akumaraguru/EE40_Remote_Control/README.md

EE40_Remote_Control
===================

Final Project for EE40 Fall 2014
