akumaraguru/EE40_Remote_Control/FinalHackwithSchematics.pdf

# Final Hack: Remote Control

## 1 AUTHORS

Aravind Kumaraguru, Scout Heid

## 2 DESCRIPTION

This hack enables a fully wireless remote control of the robot using cheap Nordic radios operating at 2.4 GHz. The robot will be controlled via a breadboard with two potentiometers that control the speed of the left and right motors.

## 3 MATERIALS

### Bill of Materials

Component | Quantity | Unit Price | Vendor
MSP430-G2553 | 2 | $9.99 | Ti.com (http://www.ti.com/ww/en/launchpad/launchpads-msp430.html)
Nordic NRF24L01 | 2 | $1.50 | eBay.com (http://www.ebay.com/sch/i.html?ssPageName=GSTL&_from=R40&_sacat=0&_nkw=nrf24l01&rt=nc&LH_BIN=1)
Breadboard (400 tie point) | 2 | Free | EE40 Lab
9V 48:1 gearmotors | 2 | $4.29 | robotshop.com (http://www.robotshop.com/en/481-dc-gear-motor-6-9v-pair.html)
66mm Tamiya wheels | 2 | $3.20 | robotshop.com (http://www.robotshop.com/en/tamiya-wheels-pair.html)
LM1086 Vreg | 2 | Free | EE40 Lab
LM6484 Quad Op Amp | 1 | Free | EE40 Lab
BC547B BJT | 2 | Free | EE40 Lab
10K potentiometers | 2 | $0.95 | Adafruit.com (http://www.adafruit.com/products/562)
Soft T18 Knobs | 2 | $0.50 | Adafruit.com (http://www.adafruit.com/products/2047)
Resistor (10K Ohm) | 4 | Free | EE40 Lab
Resistor (20K Ohm) | 2 | Free | EE40 Lab
Capacitor (10 uF) | 4 | Free | EE40 Lab
Diode | 2 | Free | EE40 Lab
9V battery | 2 | Free | EE40 Lab
9V battery connector | 2 | Free | EE40 Lab
Female-to-Male jumpers | 24 | Free | EE40 Lab

### Shopping List

Component | Quantity | Price
MSP430-G2553 | 1 | $9.99
Nordic NRF24L01 | 2 | $3.00
9V gearmotors | 2 | $8.58
66mm wheels | 2 | $6.40
10K potentiometers | 2 | $1.90
Soft T18 Knobs | 2 | $1.00
TOTAL | | $30.87

### Alternate Shopping List

Component | Quantity | Price
MSP430-G2553 | 1 | $9.99
Nordic NRF24L01 | 2 | $3.00
10K potentiometers | 2 | $1.90
Soft T18 Knobs | 2 | $1.00
Springs | 2 | Free
TOTAL | | $15.89
For a smaller budget, use the given motors with eccentric weights and springs.

## 4 INSTRUCTIONS

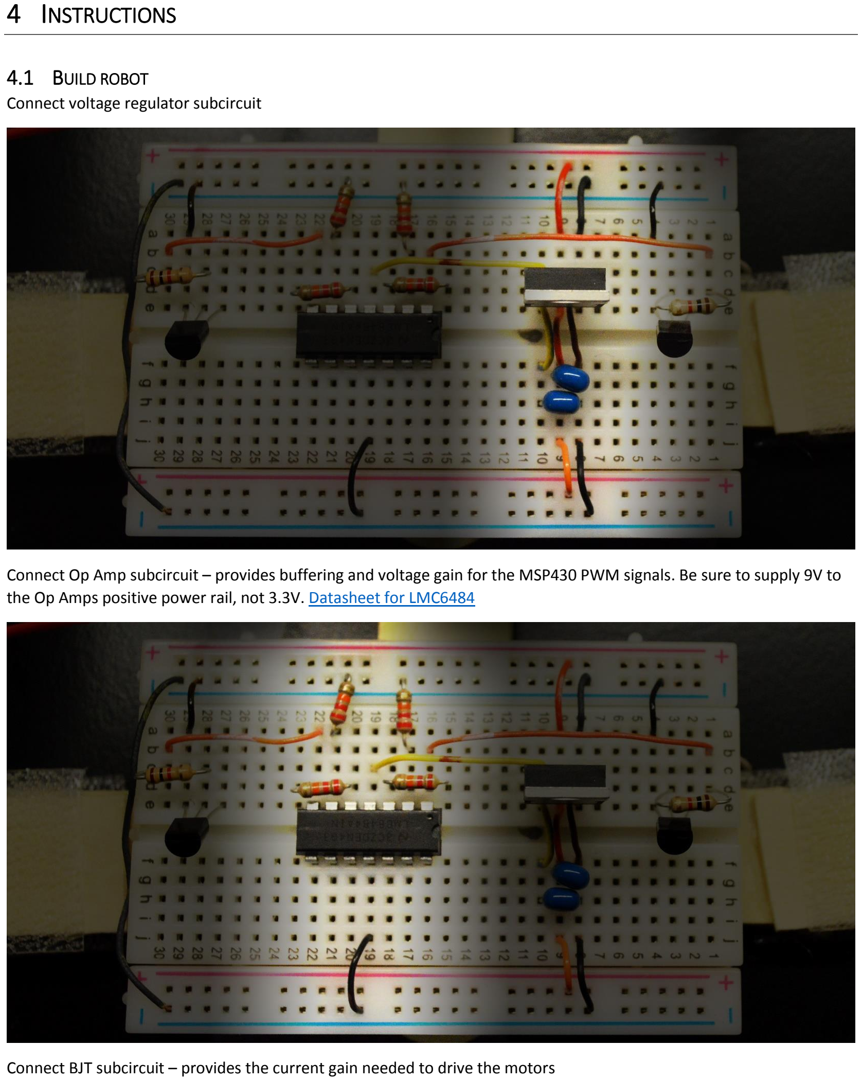
[picture p1: page 2]

4.1 BUILD ROBOT
Connect voltage regulator subcircuit

Connect Op Amp subcircuit – provides buffering and voltage gain for the MSP430 PWM signals. Be sure to supply 9V to the Op Amps positive power rail, not 3.3V. Datasheet for LMC6484 (http://www.ti.com/lit/ds/symlink/lmc6484.pdf)

Connect BJT subcircuit – provides the current gain needed to drive the motors

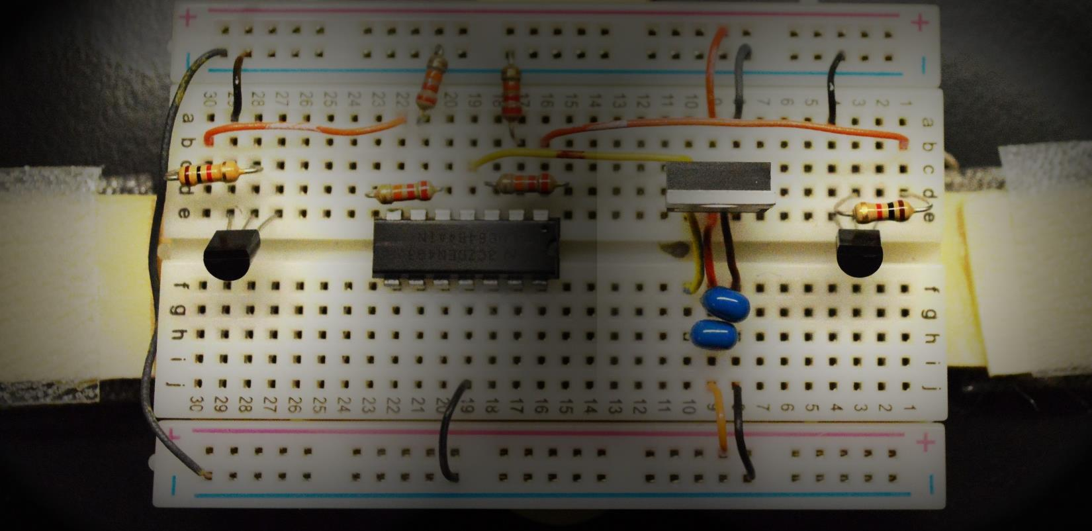
[picture p2: figure]

Ignore the resistor attached to the base of each BJT: Those were removed to improved performance. Refer to schematic for more detail!

Clip any connector on the leads of the motors and strip a small amount of insulation to that the leads can be inserted into a breadboard. Solder on the diodes in parallel as specified by the schematic.

Also, build a suitable robot frame onto which you can mount a breadboard, 2 motors, a 9V battery, and an MSP430.

4.2 BUILD REMOTE CONTROL
Connect voltage regulator subcircuit – same idea as the vreg subcircuit on the robot’s breadboard

Connect potentiometer subcircuit – a voltage divider with high resistance to minimize current draw

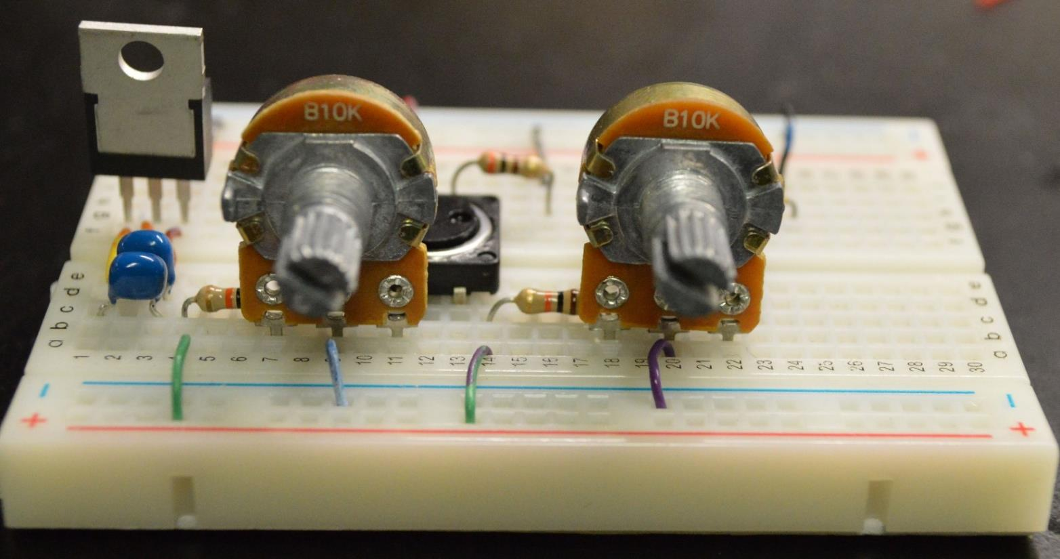
[picture p3: figure]

Ignore the button in this picture – that is from an alternate design we scrapped earlier.

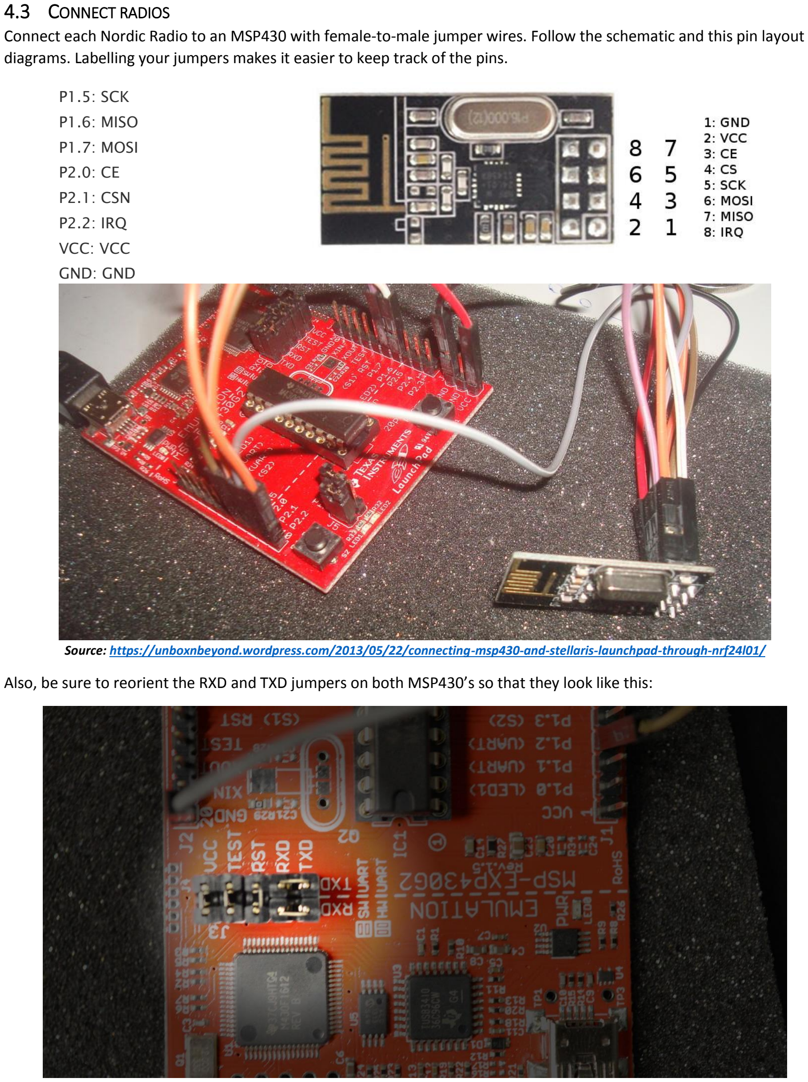
[picture p4: page 4]

4.3 CONNECT RADIOS
Connect each Nordic Radio to an MSP430 with female-to-male jumper wires. Follow the schematic and this pin layout diagrams. Labelling your jumpers makes it easier to keep track of the pins.

P1.5: SCK
P1.6: MISO
P1.7: MOSI
P2.0: CE
P2.1: CSN
P2.2: IRQ
VCC: VCC
GND: GND

Source: https://unboxnbeyond.wordpress.com/2013/05/22/connecting-msp430-and-stellaris-launchpad-through-nrf24l01/

Also, be sure to reorient the RXD and TXD jumpers on both MSP430’s so that they look like this:

4.4 SET UP DEVELOPMENT ENVIRONMENT
The code for this hack will not work with Code Composer. The Energia IDE must be used. Information on how to set up this software can easily be found online.

Download and set up Energia: http://energia.nu/download/

Download and set up the nRF24L01+ library for Energia: http://energia.nu/reference/libraries/

The example code for running the Nordic radios should now be available.

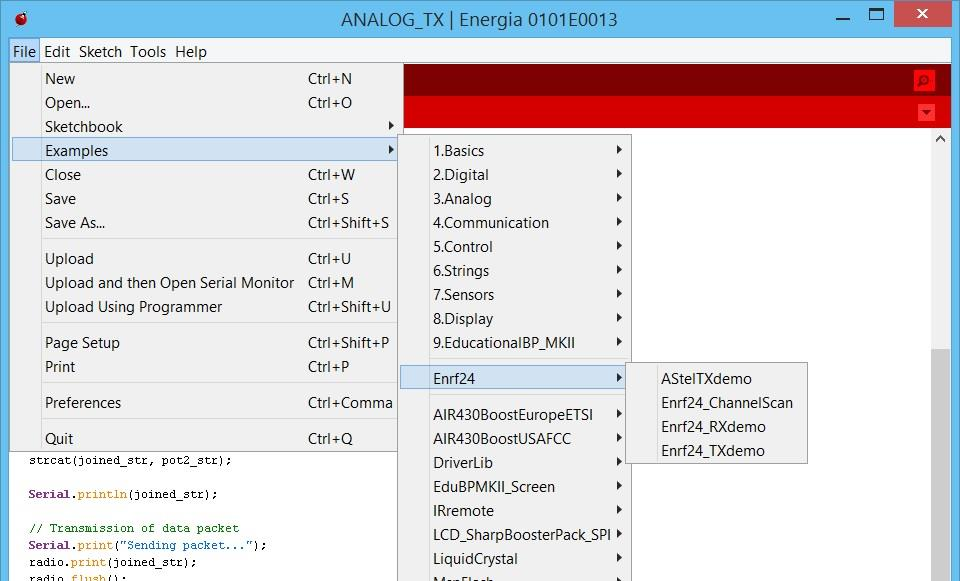
[picture p5: figure]

4.5 CODE AND TESTING
Load Enrf24_TXdemo onto one MSP430 and Enrf24_RXdemo onto the other. If the setup was successful, the red led on the TX controller will blink. The MSPs’ status can also be verified via the serial monitor in Eneriga.

Next, load ANALOG_TX onto one MSP430 and ANALOG_RX onto the other. The TX controller will connect to the remote control breadboard, and the RX will connect to the robot. Refer to the schematic to determine which pins to connect where.

Calibration: The response from the potentiometers may slightly vary, creating a constant gap between the two readings even when the potentiometers are tuned to the same angle. This can be compensated for in the RX code:

Watching the serial print statements, tweak the operation in this line so that RValue and LValue match up.

4.6 FINALIZE HACK
Attach the breadboards, motors, and microcontrollers together. Read the schematic carefully. Have fun!

## 5 DOCUMENTATION

PWM signal on oscilloscope

http://youtu.be/xF9sg3VZHmM

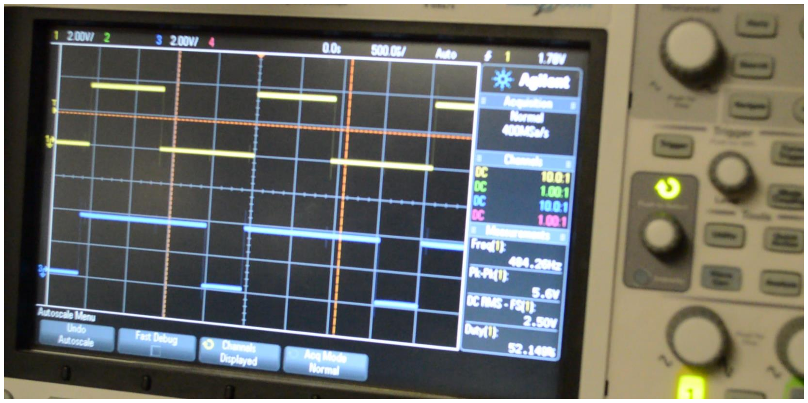
[picture p6: figure]

Test Drive

http://youtu.be/e0LC6fBKWEA

## 6 CODE

Code can be downloaded from: https://github.com/AravindK95/EE40_Remote_Control inside the Energia folder.

## 7 SOURCES

https://github.com/energia/Energia/wiki

https://unboxnbeyond.wordpress.com/2013/05/22/connecting-msp430-and-stellaris-launchpad-through-nrf24l01/

http://energia.nu/Reference_Index.html

http://www.ti.com/lit/ug/slau318f/slau318f.pdf

Voltage Regulator | Left Motor | Right Motor

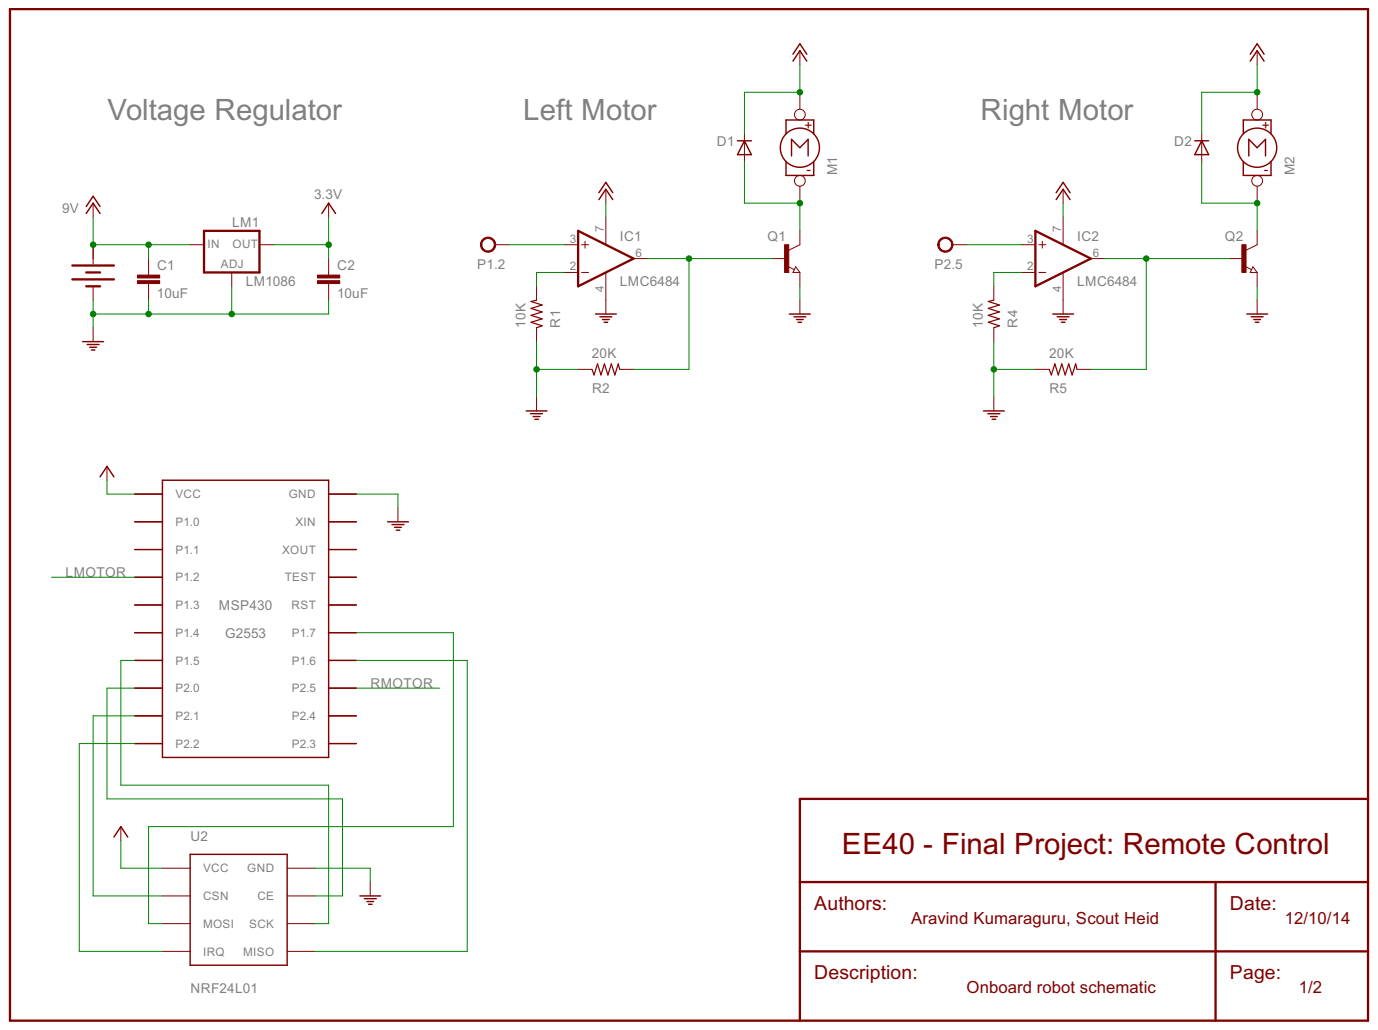
[picture p7: page 7]

EE40 - Final Project: Remote Control

Authors: Aravind Kumaraguru, Scout Heid | Date: 12/10/14

Description: Onboard robot schematic | Page: 1/2

## Voltage Regulator

Left Motor Control | Right Motor Control

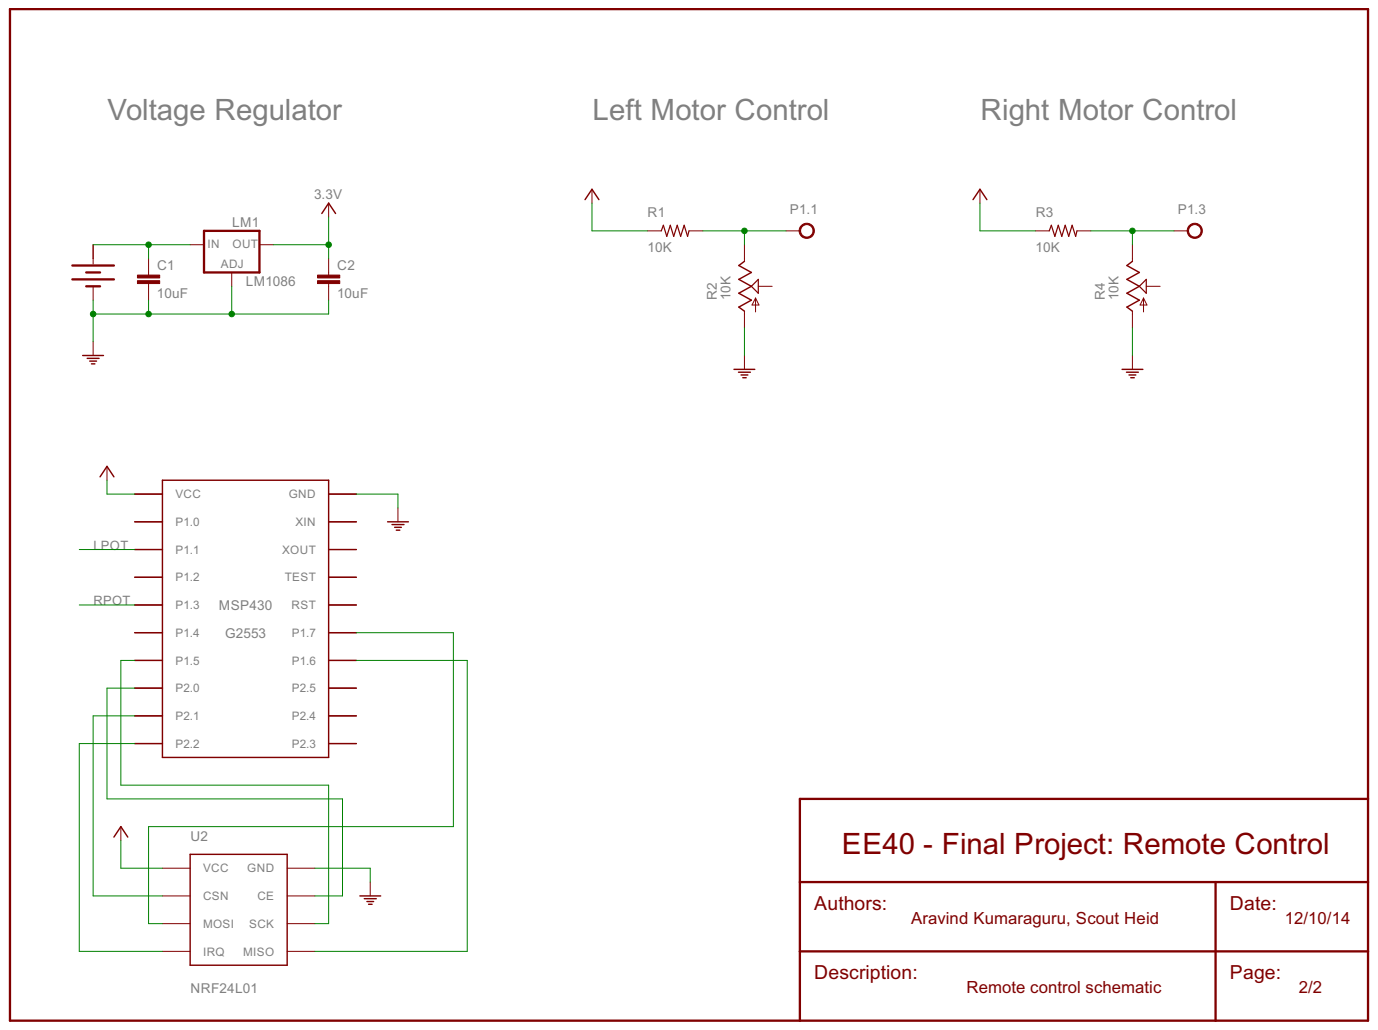
[picture p8: page 8]
MSP430; VCC; RST; TEST; XOUT; XIN; GND; ADJ; IN OUT; CSN; MOSI; IRQ; MISO; SCK; NRF24L01; LPOT; RPOT

EE40 - Final Project: Remote Control

Authors: Aravind Kumaraguru, Scout Heid | Date: 12/10/14

Description: Remote control schematic | Page: 2/2
