akumaraguru/EE40_Remote_Control/Eagle/ee40_robot_final_p1.sch

## EAGLE design Eagle/ee40_robot_final_p1.sch (2014-12-13)

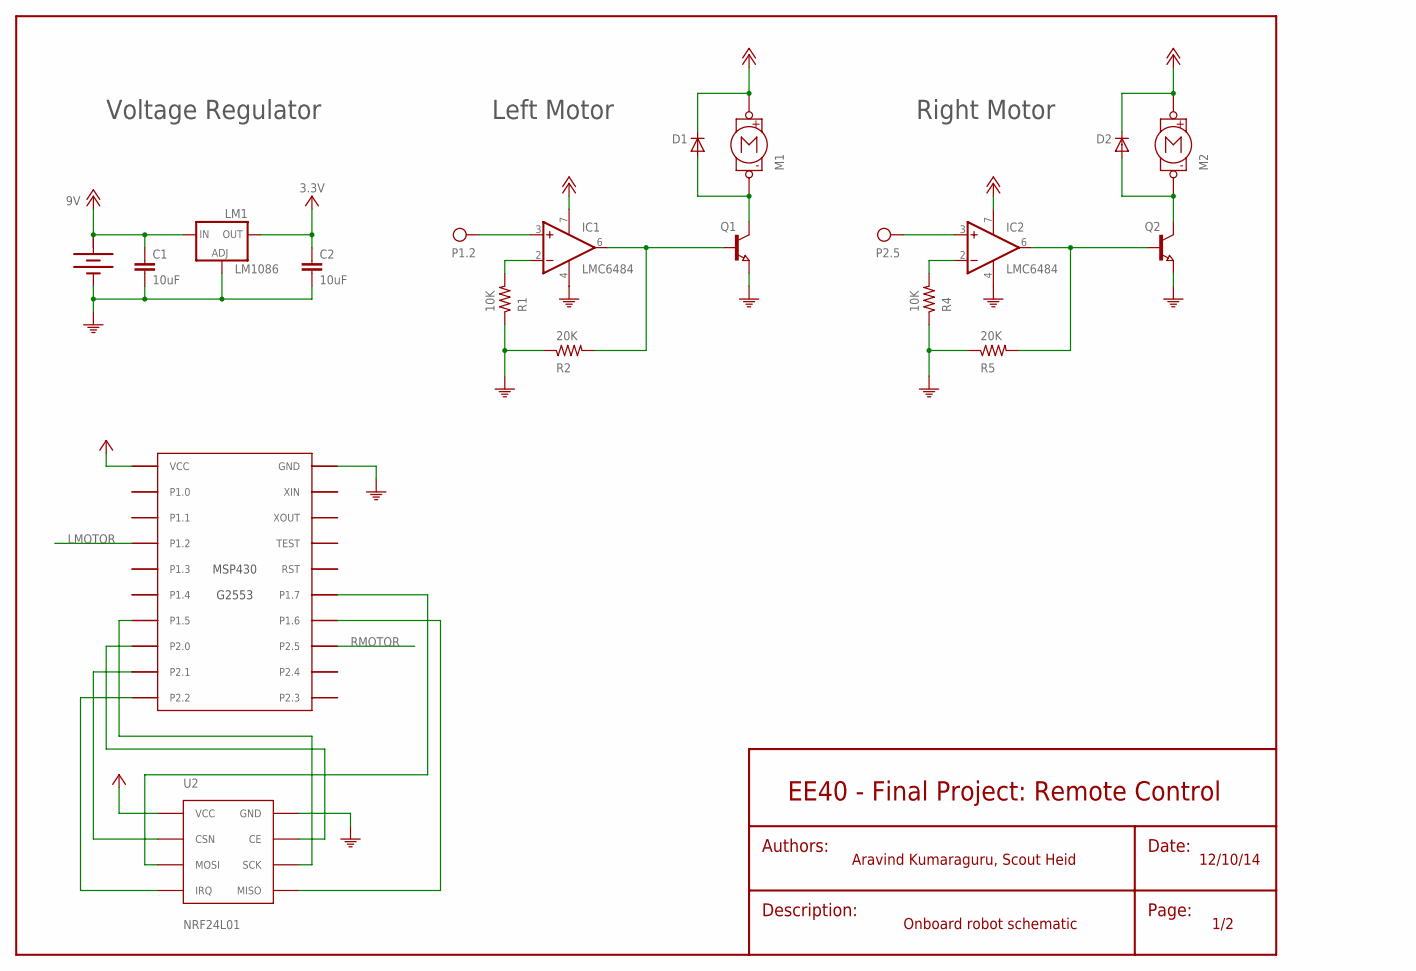
[picture p9: schematic ee40_robot_final_p1.sch]

Parts:
BAT1: 9V D-CELL; BATTERY
C1, C2: 10uF; C5B2.5
D1, D2: 1N4446; DO35-10
IC1, IC2: LMC6484; DIL08
LM1: LM1086; TO220L1
M1, M2: MOTOR
Q1, Q2: NPN-TRANSISTOR_SOT23; SOT23
R1, R4: 10K; 0204/7
R2, R5: 20K; 0204/7
U1: MSP430
U2: NRF24L01

Connections:
9V: BAT1.+, C1.1, D1.C, D2.C, IC1.7 (V+), IC2.7 (V+), LM1.3 (IN), M1.P$1 (+), M2.P$1 (+)
CE: U1.P$8 (P2.0), U2.P$1 (CE)
CSN: U1.P$9 (P2.1), U2.P$2 (CSN)
GND: BAT1.-, C1.2, C2.2, IC1.4 (V-), IC2.4 (V-), LM1.1 (ADJ), Q1.2 (E), Q2.2 (E), R1.1, R2.1, R4.1, R5.1, U1.P$20 (GND), U2.P$3 (GND)
IRQ: U1.P$10 (P2.2), U2.P$4 (IRQ)
LMOTOR: IC1.3 (+IN), U1.P$4 (P1.2)
MISO: U1.P$14 (P1.6), U2.P$5 (MISO)
MOSI: U1.P$15 (P1.7), U2.P$6 (MOSI)
unnamed: D2.A, M2.P$2 (-), Q2.3 (C)
unnamed: D1.A, M1.P$2 (-), Q1.3 (C)
unnamed: IC1.2 (-IN), R1.2
unnamed: IC2.2 (-IN), R4.2
R1: IC2.6 (OUT), Q2.1 (B), R5.2
R2: IC1.6 (OUT), Q1.1 (B), R2.2
RMOTOR: IC2.3 (+IN), U1.P$13 (P2.5)
SCK: U1.P$7 (P1.5), U2.P$7 (SCK)
VCC: C2.1, LM1.2 (OUT), U1.P$1 (VCC), U2.P$8 (VCC)

Notes on the sheet:
Left Motor
Right Motor
EE40 - Final Project: Remote Control
Authors:
Aravind Kumaraguru, Scout Heid
Voltage Regulator
Description:
Date:
Page:
Onboard robot schematic
1/2
12/10/14
