akumaraguru/EE40_Remote_Control/Eagle/ee40_robot_final_p2.sch

## EAGLE design Eagle/ee40_robot_final_p2.sch (2014-12-13)

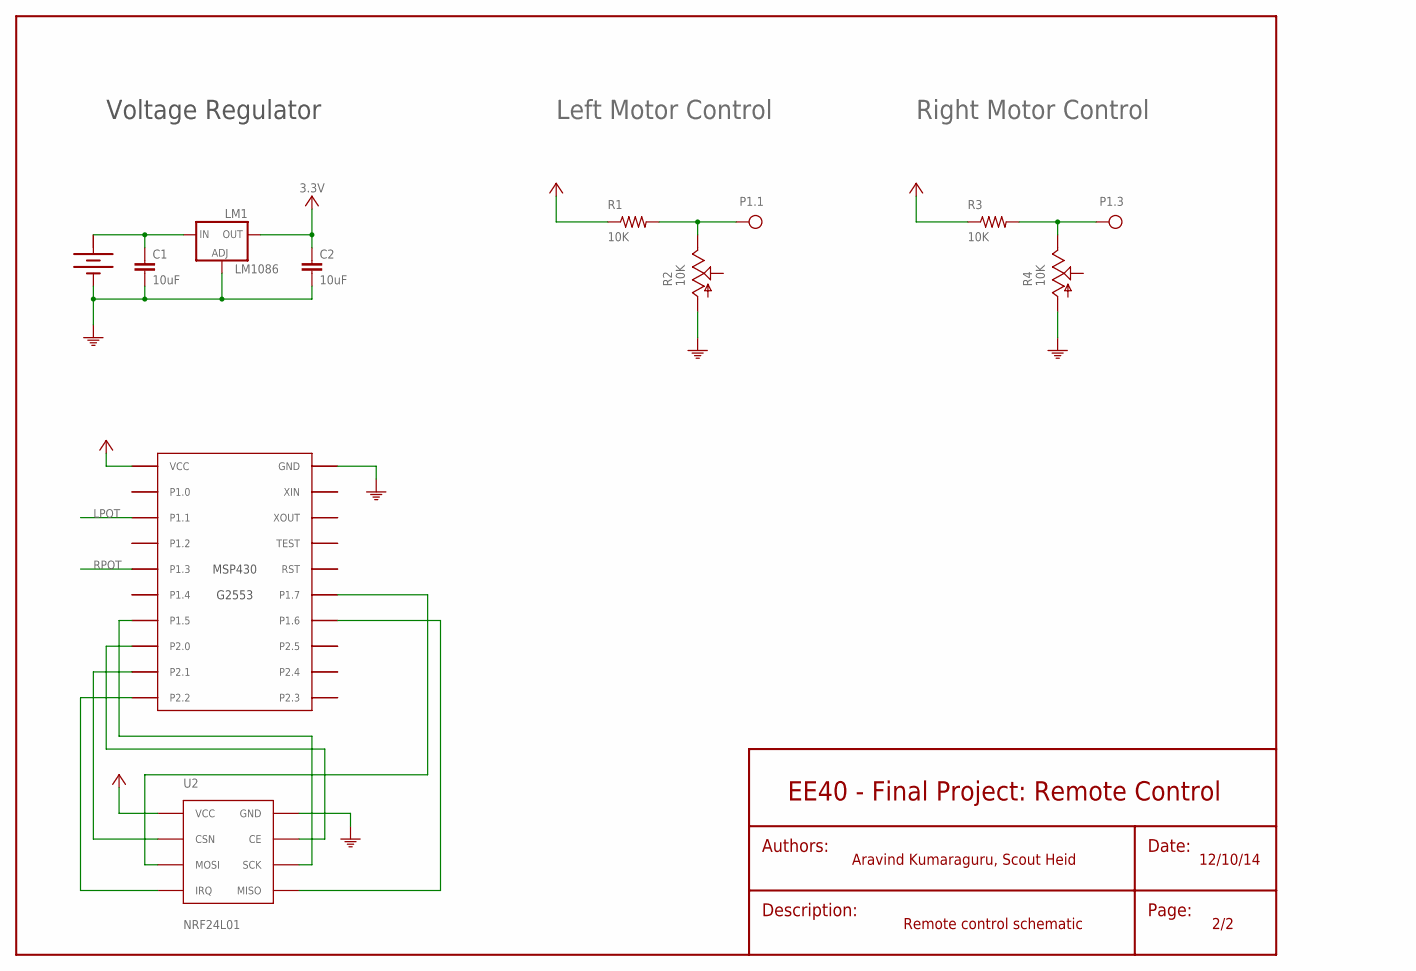
[picture p10: schematic ee40_robot_final_p2.sch]

Parts:
BAT1: 9V D-CELL; BATTERY
C1, C2: 10uF; C5B2.5
LM1: LM1086; TO220L1
R1, R3: 10K; VMTA55
R2, R4: 10K; RJ9W
U1: MSP430
U2: NRF24L01

Connections:
9V: BAT1.+, C1.1, LM1.3 (IN)
CE: U1.P$8 (P2.0), U2.P$1 (CE)
CSN: U1.P$9 (P2.1), U2.P$2 (CSN)
GND: BAT1.-, C1.2, C2.2, LM1.1 (ADJ), R2.A, R4.A, U1.P$20 (GND), U2.P$3 (GND)
IRQ: U1.P$10 (P2.2), U2.P$4 (IRQ)
LPOT: R1.2, R2.E, U1.P$3 (P1.1)
MISO: U1.P$14 (P1.6), U2.P$5 (MISO)
MOSI: U1.P$15 (P1.7), U2.P$6 (MOSI)
RPOT: R3.2, R4.E, U1.P$5 (P1.3)
SCK: U1.P$7 (P1.5), U2.P$7 (SCK)
VCC: C2.1, LM1.2 (OUT), R1.1, R3.1, U1.P$1 (VCC), U2.P$8 (VCC)

Notes on the sheet:
EE40 - Final Project: Remote Control
Authors:
Aravind Kumaraguru, Scout Heid
Voltage Regulator
Description:
Date:
Page:
Remote control schematic
2/2
12/10/14
Left Motor Control
Right Motor Control
