akumaraguru/EE40_Remote_Control/(commit log)

2014-12-13 Initial Commit
    Includes overall documentation, code, and schematic files.
    [ee40_robot_final_p1.sch, ee40_robot_final_p2.sch]
2014-12-13 Added merged pdf
    Documentation now contains schematics.
